boert/RFT-kicad-library/README.md

# RFT-kicad-library
KiCAD symbols for semiconductors from GDR

KiCAD-Symbole für in der DDR hergestellte Halbleiter

```
Achtung: Verwendung auf eigene Gefahr!

Die Bauteile wurden anhand der Datenblätter erstellt und 
nur zu einem sehr kleinen Teil in realen Schaltungen geprüft.

Hinweise zu Fehlern sowie Verbesserungen und Erweiterungen werden gern entgegengenommen.

```

folgende Bauteile sind momentan enthalten:

## Analogschaltkreise

Bezeichnung | Beschreibung
----------- | ------------
A109D       | Universeller OPV
A202D       | Aufnahme-, Mikrofon- und Wiedergabeverstärker
A211D       | 1W NF-Verstärker (optional mit Kühlfahne)
A220D       | FM-ZF-Verstärker und Demodulator
A225D       | FM-ZF-Verstärker
A244D       | Integrierter AM-Empfänger bis 30 MHz
A274D       | Höhen- und Tiefeneinstellung von Stereo-NF-Verstärkern
A277D       | Ansteuerschaltkreis für 12 LED, wahlweise im Punkt- oder Bandbetrieb
A290D       | Stereo-Dekoder
A301D       | Initiatorschaltung
A301V       | Initiatorschaltung
A302D       | Schwellspannungsschaltkreis
B060D       | Kleinleistungs-BIFET-OPV, externe Frequenzkompensation, Offsetabgleich
B061D       | Kleinleistungs-BIFET-OPV, interne Frequenzkompensation, Offsetabgleich
B062D       | zweifach Kleinleistungs-BIFET-OPV, interne Frequenzkompensation
B064D       | vierfach Kleinleistungs-BIFET-OPV, interne Frequenzkompensation
B066D       | Kleinleistungs-BIFET-OPV, interne Frequenzkompensation, Offsetabgleich, Leistungssteuerung
B080D       | BIFET-OPV, externe Frequenzkompensation, Offsetabgleich
B081D       | BIFET-OPV, interne Frequenzkompensation, Offsetabgleich
B082D       | zweifach BIFET-OPV, interne Frequenzkompensation
B083D       | zweifach BIFET-OPV, interne Frequenzkompensation, Offsetabgleich
B084D       | vierfach BIFET-OPV, interne Frequenzkompensation
B109D       | Universeller OPV
B165D       | Leistungs-OPV 20 W
B176D       | Programmierbarer OPV
B177D       | Programmierbarer OPV
B222D       | Doppelgegentaktmischer
B260D       | Ansteuerschaltkreis für Schaltnetzteile
B2761D      | 2-fach OPV mit offenem Kollektor
B2765D      | 2-fach OPV mit offenem Kollektor
B2765S      | 2-fach OPV mit Darlington-Ausgang
B2960VG     | Schaltregler-Schaltkreis
B303D       | Initiatorschaltkreis für induktive, kapazitive und optische Näherungsschalter
B3040DA     | Treiber-Sensor für Leiterplattentester
B304D       | Initiatorschaltkreis für induktive, kapazitive und optische Näherungsschalter
B305D       | Initiatorschaltkreis für induktive, kapazitive und optische Näherungsschalter, mit LED-Ausgang
B306D       | Initiatorschaltkreis für induktive, kapazitive und optische Näherungsschalter
B308D       | NF-Verstärker für Telefonhörer
B315D       | Transistor-Leistungs-Array
B3170V      | Positiv-Spannungsregler, einstellbar
B3171V      | Positiv-Spannungsregler, einstellbar
B318D       | NF-Verstärker für Telefonhörer
B325D       | Transistor-Leistungs-Array
B3370V      | Negativ-Spannungsregler, einstellbar
B3371V      | Negativ-Spannungsregler, einstellbar
B340D       | Transistor-Kleinleistungs-Array
B341D       | Transistor-Kleinleistungs-Array
B342D       | Transistor-Kleinleistungs-Array
B360D       | Transistor-Leistungs-Array
B3718VC     | Schrittmotor-Treiberschaltkreis
B380D       | Transistor-Leistungs-Array
B390D       | Regler für Gleichstromkleinstmotoren
B391D       | Motorprozessor für Kassettenlaufwerke
B3925DD     | Motorprozessor für Diskettenlaufwerke
B4002D      | Schnittstelle Logik zu Leistung
B411DD      | Präzisions-BIFET-OPV, interne Frequenzkompensation, Offsetabgleich
B451G       | Magnetisch betätigter (Hall-)Schalter
B452G       | Magnetisch betätigter (Hall-)Schalter
B453G       | Magnetisch betätigter (Hall-)Schalter
B460G       | Hall-Sensor mit analogem Ausgang
B461G       | Magnetisch betätigter (Hall-)Schalter, mit Freigabeeingang
B462G       | Magnetisch betätigter (Hall-)Schalter, mit Freigabeeingang
B4206D      | Drehzahlregelung, stromgeführt
B4207D      | Drehzahlregelung, tachogeführt
B4211D      | Drehzahlregelung, tachogeführt, Phasenanschnitt
B4761D      | 4-fach OPV mit offenem Kollektor
B4765D      | 4-fach OPV mit offenem Kollektor
B551N       | Temperatursensor 1 µA/K
B555D       | Zeitgeber mit 200-mA-Ausgang
B556D       | Zeitgeber mit 200-mA-Ausgang
B589N       | Referenzspannungsquelle 1,235 V
B611D       | OPV mit TTL-Ausgang
B615D       | OPV mit TTL-Ausgang
B621D       | OPV mit TTL-Ausgang
B625D       | OPV mit TTL-Ausgang
B631D       | OPV mit offenem Kollektor
B635D       | OPV mit offenem Kollektor
B654D       | Servomotor-Steuerschaltkreis mit Brückenschaltung
B761D       | OPV mit offenem Kollektor
B765D       | OPV mit offenem Kollektor
B861D       | OPV mit offenem Kollektor
B865D       | OPV mit offenem Kollektor
C500D       | Analog-Teil eines 2-Flanken-Umsetzers (14 Bit, 4 1/4 Digit)
C501D       | Analog-Teil eines 2-Flanken-Umsetzers (11 Bit, 3 1/2 Digit)
C502D       | Digital-Teil des 2-Flanken-Umsetzers mit Siebensegmentausgang
C504D       | Digital-Teil des 2-Flanken-Umsetzers mit BCD-Ausgang
C520D       | A/D-Umsetzer -2..+3 Stellen mit BCD-Ausgang
C560C       | 8-bit-D/A-Wandler mit Latch
C5650C      | 10-bit-D/A-Wandler ohne Latch
C5658C      | 8-bit-D/A-Wandler ohne Latch
C565C       | 12-bit-D/A-Wandler ohne Latch
C570C       | 8-bit-A/D-Wandler ohne Tristate
C571C       | 10-bit-A/D-Wandler ohne Tristate
C574C       | 12-bit-A/D-Wandler mit 8-bit-Businterface
C670C       | 8-bit-A/D-Wandler mit Tristate
C7136D      | 3 1/2-stelliger A/D-Umsetzer für LCD-Ansteuerung
E310        | Blinkgeberschaltung
U7650DD     | Chopperstabilisierter CMOS-OPV

## Optoelektronik

Bezeichnung | Beschreibung
----------- | ------------
L110C       | CCD-Zeile, 256 Pixel
L133C       | CCD-Zeile, 1024 Pixel
MB101       | GaAs-LED + Si-npn-Fototransistor
MB104       | Optoelektronischer Koppler aus IR-Diode und npn-Si-Fototransistor
MB105       | Optoelektronischer Koppler aus IR-Diode und npn-Si-Fototransistor
MB106       | GaAs-LED + Si-npn-Fototransistor
MB110       | Optoelektronischer Koppler aus GaAs-LED und Si-Fotodiode
MB111       | Optoelektronischer Koppler aus GaAs-LED und Si-Fotodiode, Ausgang open-collector, TTL-kompatibel
MB123       | Gabelkoppler: GaAs-LED + Si-Fototransistor
MB125       | Reflexkoppler: GaAs-LED + Si-Fototransistor
MB126       | Reflexkoppler: GaAs-LED + Si-Fototransistor
MB133       | IR-LED + Si-npn-Fototransistor
MB134       | IR-LED + Si-npn-Fototransistor
MB135       | IR-LED + Si-npn-Fototransistor
SP201       | Si-npn-Fototransistor in Plastverkappung
SP211       | Si-npn-Planar-Fototransistor im Metall-Keramik-Gehäuse
VQ110       | Infrarotemitterdiode 940nm, 4mm, rund
VQ120       | Infrarotemitterdiode 940nm, In-Loch-Montage
VQ121       | GaAs Infrarotemitterdiode 940nm, 2mm
VQ123       | Infrarotemitterdiode 940nm, 3mm, rund
VQ125       | Infrarotemitterdiode 900nm...980nm, 5mm, rund
VQA10       | Leuchtdiode rot, 635nm, 5mm, rund, rot diffus
VQA12       | Leuchtdiode rot, 630nm...690nm, 4mm, rund, rot diffus
VQA13       | Leuchtdiode rot, 660nm, 5mm, rund, diffus
VQA14       | Leuchtdiode rot, 635nm, 5mm, rechteckig anreihbar, teildiffus
VQA15       | Leuchtdiode rot, 660nm, 2mm, rund, farblos
VQA16       | Leuchtdiode rot, 635nm, 5mm, rund, Farbe klar
VQA17       | Leuchtdiode rot, 635nm, 3mm, rund, Farbe diffus
VQA18       | Leuchtdiode rot, 635nm, 5mm, rechteckig nicht anreihbar, teildiffus
VQA23       | Leuchtdiode grün, 560nm, 5mm, rund, diffus
VQA24       | Leuchtdiode grün, 560nm, 5mm, rechteckig anreihbar, teildiffus
VQA25       | Leuchtdiode grün, 560nm, 2mm, rund, Farbe klar
VQA26       | Leuchtdiode grün, 560nm, 5mm, rund, Farbe klar
VQA27       | Leuchtdiode grün, 560nm, 3mm, rund, Farbe diffus
VQA28       | Leuchtdiode grün, 560nm, 5mm, rechteckig nicht anreihbar, teildiffus
VQA33       | Leuchtdiode gelb, 590nm, 5mm, rund, diffus
VQA34       | Leuchtdiode gelb, 590nm, 5mm, rechteckig anreihbar, teildiffus
VQA35       | Leuchtdiode gelb, 590nm, 2mm, rund, Farbe klar
VQA36       | Leuchtdiode gelb, 590nm, 5mm, rund, Farbe klar
VQA37       | Leuchtdiode gelb, 590nm, 3mm, rund, Farbe diffus
VQA38       | Leuchtdiode gelb, 590nm, 5mm, rechteckig nicht anreihbar, teildiffus
VQA46       | Leuchtdiode orange, 610nm, 5mm, rund, Farbe klar
VQA47       | Leuchtdiode orange, 610nm, 3mm, rund, Farbe diffus
VQB16       | einstellige Lichtschachtanzeige, rot
VQB17       | einstellige Lichtschachtanzeige, rot, gemeinsame Kathode
VQB18       | einstellige Lichtschachtanzeige, rot, gemeinsame Anode
VQB26       | einstellige Lichtschachtanzeige, grün
VQB27       | einstellige Lichtschachtanzeige, grün, gemeinsame Kathode
VQB28       | einstellige Lichtschachtanzeige, grün, gemeinsame Anode
VQB37       | einstellige LED-Anzeige, rot, 3mm, gemeinsame Kathode
VQB71       | einstellige LED-Anzeige, rot, 7mm, gemeinsame Anode
VQB73       | plus/minus LED-Anzeige, rot, 7mm, gemeinsame Anode
VQB200      | 16-Segment-Lichtemitteranzeige, grün, gemeinsame Kathode
VQB201      | 16-Segment-Lichtemitteranzeige, grün, gemeinsame Anode
VQE11       | 1,5-stellige Lichtschachtanzeige, rot, gemeinsame Kathode
VQE12       | 1,5-stellige Lichtschachtanzeige, rot, gemeinsame Anode
VQE13       | zweistellige Lichtschachtanzeige, rot, gemeinsame Kathode
VQE14       | zweistellige Lichtschachtanzeige, rot, gemeinsame Anode
VQE21       | 1,5-stellige Lichtschachtanzeige, grün, gemeinsame Kathode
VQE22       | 1,5-stellige Lichtschachtanzeige, grün, gemeinsame Anode
VQE23       | zweistellige Lichtschachtanzeige, grün, gemeinsame Kathode
VQE24       | zweistellige Lichtschachtanzeige, grün, gemeinsame Anode

## Transistoren & Dioden

Bezeichnung | Beschreibung
----------- | ------------
GA100       | Germanium-Universaldiode, U<sub>R</sub>=20V, I<sub>F</sub>=20mA
GA101       | Germanium-Universaldiode, U<sub>R</sub>=40V, I<sub>F</sub>=15mA
GA102       | Germanium-Universaldiode, U<sub>R</sub>=60V, I<sub>F</sub>=12mA
GA103       | Germanium-Universaldiode, U<sub>R</sub>=80V, I<sub>F</sub>=10mA
GA104       | Germanium-Universaldiode, U<sub>R</sub>=110V, I<sub>F</sub>=10mA
GA105       | Germanium-Universaldiode, U<sub>R</sub>=20V, I<sub>F</sub>=20mA
GA108       | Germanium-Universaldiode, U<sub>R</sub>=80V, I<sub>F</sub>=20mA
GC100       | Ge-PNP-Transistor, U<sub>CE</sub>=-10V, I<sub>C</sub>=-15mA
GC101       | Ge-PNP-Transistor, rauscharm, U<sub>CE</sub>=-10V, I<sub>C</sub>=-15mA
GC115       | Ge-PNP-Transistor, U<sub>CE</sub>=-20V, I<sub>C</sub>=-50mA
GC116       | Ge-PNP-Transistor, U<sub>CE</sub>=-20V, I<sub>C</sub>=-50mA
GC117       | Ge-PNP-Transistor, rauscharm, U<sub>CE</sub>=-20V, I<sub>C</sub>=-50mA
GC120       | Ge-PNP-Transistor, U<sub>CE</sub>=-20V, I<sub>C</sub>=-150mA
GC121       | Ge-PNP-Transistor, U<sub>CE</sub>=-20V, I<sub>C</sub>=-150mA
GC122       | Ge-PNP-Transistor, U<sub>CE</sub>=-33V, I<sub>C</sub>=-150mA
GC123       | Ge-PNP-Transistor, U<sub>CE</sub>=-66V, I<sub>C</sub>=-150mA
GC301       | Ge-PNP-Transistor, U<sub>CE</sub>=-32V, I<sub>C</sub>=-500A
GD100       | Ge-PNP-Leistungstransistor, U<sub>CE</sub>=-18V, I<sub>C</sub>=-1,3A
GD110       | Ge-PNP-Leistungstransistor, U<sub>CE</sub>=-18V, I<sub>C</sub>=-1,3A
GD120       | Ge-PNP-Leistungstransistor, U<sub>CE</sub>=-30V, I<sub>C</sub>=-1,3A
GD130       | Ge-PNP-Leistungstransistor, U<sub>CE</sub>=-58V, I<sub>C</sub>=-1,3A
GD150       | Ge-PNP-Leistungstransistor, U<sub>CE</sub>=-18V, I<sub>C</sub>=-3,0A
GD160       | Ge-PNP-Leistungstransistor, U<sub>CE</sub>=-18V, I<sub>C</sub>=-3,0A
GD170       | Ge-PNP-Leistungstransistor, U<sub>CE</sub>=-30V, I<sub>C</sub>=-3,0A
GD175       | Ge-PNP-Leistungstransistor, U<sub>CE</sub>=-48V, I<sub>C</sub>=-3,0A
GD180       | Ge-PNP-Leistungstransistor, U<sub>CE</sub>=-60V, I<sub>C</sub>=-3,0A
GD240       | Ge-PNP-Leistungstransistor, U<sub>CE</sub>=-25V, I<sub>C</sub>=-3,0A, P<sub>tot</sub>=10W
GD241       | Ge-PNP-Leistungstransistor, U<sub>CE</sub>=-35V, I<sub>C</sub>=-3,0A, P<sub>tot</sub>=10W
GD242       | Ge-PNP-Leistungstransistor, U<sub>CE</sub>=-48V, I<sub>C</sub>=-3,0A, P<sub>tot</sub>=10W
GD243       | Ge-PNP-Leistungstransistor, U<sub>CE</sub>=-60V, I<sub>C</sub>=-3,0A, P<sub>tot</sub>=10W
GD244       | Ge-PNP-Leistungstransistor, U<sub>CE</sub>=-70V, I<sub>C</sub>=-3,0A, P<sub>tot</sub>=10W
GF100       | Ge-PNP-HF-Transistor, I<sub>C</sub>=-15mA
GF105       | Ge-PNP-HF-Transistor, I<sub>C</sub>=-15mA
GF120       | Ge-PNP-HF-Transistor, U<sub>CE</sub>=-15V, I<sub>C</sub>=-10mA
GF121       | Ge-PNP-HF-Transistor, U<sub>CE</sub>=-15V, I<sub>C</sub>=-10mA
GF122       | Ge-PNP-HF-Transistor, U<sub>CE</sub>=-15V, I<sub>C</sub>=-10mA
GF145       | Ge-PNP-HF-Transistor, U<sub>CE</sub>=-15V, I<sub>C</sub>=-10mA
GF147       | Ge-PNP-HF-Transistor, U<sub>CE</sub>=-15V, I<sub>C</sub>=-10mA
GS109       | Ge-PNP-Schalttransistor, U<sub>CE</sub>=-15V, I<sub>C</sub>=-50mA
GS111       | Ge-PNP-Schalttransistor, U<sub>CE</sub>=-15V, I<sub>C</sub>=-200mA
GS112       | Ge-PNP-Schalttransistor, U<sub>CE</sub>=-15V, I<sub>C</sub>=-200mA
GS121       | Ge-PNP-Schalttransistor, U<sub>CE</sub>=-20V, I<sub>C</sub>=-100mA
GS122       | Ge-PNP-Schalttransistor, U<sub>CE</sub>=-20V, I<sub>C</sub>=-100mA
OC815       | Ge-PNP-Transistor, U<sub>CE</sub>=-20V, I<sub>C</sub>=-50mA
OC816       | Ge-PNP-Transistor, U<sub>CE</sub>=-20V, I<sub>C</sub>=-50mA
OC817       | Ge-PNP-Transistor, rauscharm, U<sub>CE</sub>=-20V, I<sub>C</sub>=-50mA
OC820       | Ge-PNP-Transistor, U<sub>CE</sub>=-20V, I<sub>C</sub>=-150mA
OC821       | Ge-PNP-Transistor, U<sub>CE</sub>=-20V, I<sub>C</sub>=-150mA
OC822       | Ge-PNP-Transistor, U<sub>CE</sub>=-33V, I<sub>C</sub>=-150mA
OC823       | Ge-PNP-Transistor, U<sub>CE</sub>=-66V, I<sub>C</sub>=-150mA
OC830       | Ge-PNP-Leistungstransistor, U<sub>CE</sub>=-18V, I<sub>C</sub>=-1,3A
OC831       | Ge-PNP-Leistungstransistor, U<sub>CE</sub>=-18V, I<sub>C</sub>=-1,3A
OC832       | Ge-PNP-Leistungstransistor, U<sub>CE</sub>=-30V, I<sub>C</sub>=-1,3A
OC833       | Ge-PNP-Leistungstransistor, U<sub>CE</sub>=-58V, I<sub>C</sub>=-1,3A
OC835       | Ge-PNP-Leistungstransistor, U<sub>CE</sub>=-18V, I<sub>C</sub>=-3,0A
OC836       | Ge-PNP-Leistungstransistor, U<sub>CE</sub>=-18V, I<sub>C</sub>=-3,0A
OC837       | Ge-PNP-Leistungstransistor, U<sub>CE</sub>=-30V, I<sub>C</sub>=-3,0A
OC838       | Ge-PNP-Leistungstransistor, U<sub>CE</sub>=-60V, I<sub>C</sub>=-3,0A
OC870       | Ge-PNP-Transistor, U<sub>CE</sub>=-10V, I<sub>C</sub>=-15mA
OC871       | Ge-PNP-HF-Transistor, I<sub>C</sub>=-15mA
OC872       | Ge-PNP-HF-Transistor, I<sub>C</sub>=-15mA
OC880       | Ge-PNP-HF-Transistor, U<sub>CE</sub>=-15V, I<sub>C</sub>=-10mA
OC881       | Ge-PNP-HF-Transistor, U<sub>CE</sub>=-15V, I<sub>C</sub>=-10mA
OC882       | Ge-PNP-HF-Transistor, U<sub>CE</sub>=-25V, I<sub>C</sub>=-10mA
GY099       | Ge-Diode, U<sub>R</sub>=12V, I<sub>F</sub>=100mA
GY100       | Ge-Diode, U<sub>R</sub>=24V, I<sub>F</sub>=100mA
GY101       | Ge-Diode, U<sub>R</sub>=40V, I<sub>F</sub>=100mA
GY102       | Ge-Diode, U<sub>R</sub>=75V, I<sub>F</sub>=100mA
GY103       | Ge-Diode, U<sub>R</sub>=100V, I<sub>F</sub>=100mA
GY104       | Ge-Diode, U<sub>R</sub>=150V, I<sub>F</sub>=100mA
GY105       | Ge-Diode, U<sub>R</sub>=200V, I<sub>F</sub>=100mA
SA403       | Si-Planar-Diode, U<sub>R</sub>=25V, I<sub>F</sub>=30mA, Farbpunkt rot
SA412       | Si-Epitaxie-Diode, U<sub>R</sub>=20V, I<sub>F</sub>=80mA, Farbpunkt gelb
SA418       | Si-Epitaxie-Diode, U<sub>R</sub>=80V, I<sub>F</sub>=100mA, Farbpunkt grün
SAL41       | Silizium-Doppeldiode, schneller Schalter
SAL41B      | Silizium-Doppeldiode, schneller Schalter
SAL41K      | Silizium-Doppeldiode, schneller Schalter, ohne Mittelabgriff
SAL43       | Silizium-Mehrfachdiode, schneller Schalter
SAL45       | Silizium-Mehrfachdiode, schneller Schalter
SAM42       | Si-Doppeldiode, gemeinsame Kathode, schneller Schalter
SAM43       | Si-Dreifachdiode, gemeinsame Kathode, schneller Schalter
SAM44       | Si-Vierfachdiode, gemeinsame Kathode, schneller Schalter
SAM45       | Si-Fünffachdiode, gemeinsame Kathode, schneller Schalter
SAM62       | Si-Doppeldiode, gemeinsame Anode, schneller Schalter
SAM63       | Si-Dreifachdiode, gemeinsame Anode, schneller Schalter
SAM64       | Si-Vierfachdiode, gemeinsame Anode, schneller Schalter
SAM65       | Si-Fünffachdiode, gemeinsame Anode, schneller Schalter
SAY10       | Si-Schaltdiode, U<sub>R</sub>=50V, I<sub>F</sub>=175mA, 3. rot, 4. rot
SAY11       | Si-Schaltdiode, U<sub>R</sub>=25V, I<sub>F</sub>=115mA, 3. rot, 4. gelb
SAY12       | Si-Schaltdiode, U<sub>R</sub>=50V, I<sub>F</sub>=300mA, orange (alt: 3. rot, 4. orange)
SAY13       | Si-Schaltdiode, Markierung 3. rot, 4. grün
SAY14       | Si-Schaltdiode, U<sub>R</sub>=25V, I<sub>F</sub>=115mA, 3. rot, 4. blau
SAY15       | Si-Schaltdiode, U<sub>R</sub>=15V, I<sub>F</sub>=75mA, 3. rot, 4. weiß
SAY16       | Si-Schaltdiode, U<sub>R</sub>=30V, I<sub>F</sub>=300mA, grün (alt: 3. gelb, 4. rot)
SAY17       | Si-Schaltdiode, U<sub>R</sub>=50V, I<sub>F</sub>=175mA, rot
SAY18       | Si-Schaltdiode, U<sub>R</sub>=25V, I<sub>F</sub>=115mA, gelb
SAY20       | Si-Schaltdiode, U<sub>R</sub>=15V, I<sub>F</sub>=75mA, blau
SAY30       | Si-Planar-Diode, U<sub>R</sub>=25V, I<sub>F</sub>=30mA
SAY32       | Si-Planar-Diode, U<sub>R</sub>=25V, I<sub>F</sub>=50mA
SAY40       | Si-Planar-Diode, U<sub>R</sub>=15V, I<sub>F</sub>=30mA
SAY42       | Si-Planar-Diode, U<sub>R</sub>=15V, I<sub>F</sub>=50mA
SAY50       | Si-Doppeldiode, gemeinsame Kathode
SAY52       | Si-Doppeldiode, gemeinsame Kathode
SAY60       | Si-Doppeldiode, gemeinsame Kathode
SAY62       | Si-Doppeldiode, gemeinsame Kathode
SAY73       | Si-Schaltdiode, U<sub>R</sub>=50V, I<sub>F</sub>=300mA, weiß
SAZ12       | Si-Kapazitätsdiode, U<sub>R</sub>=18V, f<sub>Q</sub>>10GHz
SAZ13       | Si-Kapazitätsdiode, U<sub>R</sub>=18V, f<sub>Q</sub>>20GHz
SC206       | Si-NPN-Transistor, U<sub>ce</sub>=20V, I<sub>c</sub>=100mA, E-Line
SC207       | Si-NPN-Transistor, U<sub>ce</sub>=20V, I<sub>c</sub>=100mA, E-Line
SC236       | Si-NPN-Transistor für NF-Vor- und Treiberstufen, U<sub>ce</sub>=20V, I<sub>c</sub>=100mA, E-Line
SC237       | Si-NPN-Transistor für NF-Vor- und Treiberstufen, U<sub>ce</sub>=45V, I<sub>c</sub>=100mA, E-Line
SC238       | Si-NPN-Transistor für NF-Vor- und Treiberstufen, U<sub>ce</sub>=20V, I<sub>c</sub>=100mA, E-Line
SC239       | Si-NPN-Transistor für NF-Vor- und Treiberstufen, rauscharm, U<sub>ce</sub>=20V, I<sub>c</sub>=100mA, E-Line
SC307       | Si-PNP-Transistor, NF, allgemein
SC308       | Si-PNP-Transistor, NF, allgemein
SC309       | Si-PNP-Transistor, NF, allgemein, rauscharm
SD168       | Si-NPN-Leistungstransistor, U<sub>ce</sub>=300V, I<sub>c</sub>=3A, TO-3
SF121       | Si-NPN-HF-Transistor, U<sub>ce</sub>=20V, I<sub>c</sub>=100mA, TO-39
SF122       | Si-NPN-HF-Transistor, U<sub>ce</sub>=33V, I<sub>c</sub>=100mA, TO-39
SF123       | Si-NPN-HF-Transistor, U<sub>ce</sub>=66V, I<sub>c</sub>=100mA, TO-39
SF126       | Si-NPN-HF-Transistor, U<sub>ce</sub>=20V, I<sub>c</sub>=500mA, TO-39
SF127       | Si-NPN-HF-Transistor, U<sub>ce</sub>=30V, I<sub>c</sub>=500mA, TO-39
SF128       | Si-NPN-HF-Transistor, U<sub>ce</sub>=60V, I<sub>c</sub>=500mA, TO-39
SF129       | Si-NPN-HF-Transistor, U<sub>ce</sub>=80V, I<sub>c</sub>=500mA, TO-39
SF131       | Si-NPN-HF-Transistor, U<sub>ce</sub>=12V, I<sub>c</sub>=50mA, TO-18
SF132       | Si-NPN-HF-Transistor, U<sub>ce</sub>=15V, I<sub>c</sub>=50mA, TO-18
SF136       | Si-NPN-HF-Transistor, U<sub>ce</sub>=12V, I<sub>c</sub>=200mA, TO-18
SF137       | Si-NPN-HF-Transistor, U<sub>ce</sub>=20V, I<sub>c</sub>=200mA, TO-18
SF150       | Si-NPN-HF-Transistor, U<sub>ce</sub>=160V, I<sub>c</sub>=50mA, TO-39
SF215       | Si-NPN-HF-Transistor, U<sub>ce</sub>=15V, I<sub>c</sub>=100mA, E-Line
SF216       | Si-NPN-HF-Transistor, U<sub>ce</sub>=20V, I<sub>c</sub>=100mA, E-Line
SF225       | Si-NPN-HF-Transistor, U<sub>ce</sub>=25V, I<sub>c</sub>=25mA, E-Line CEB!
SF235       | Si-NPN-HF-Transistor, U<sub>ce</sub>=25V, I<sub>c</sub>=25mA, E-Line
SF240       | Si-NPN-HF-Transistor, U<sub>ce</sub>=30V, I<sub>c</sub>=25mA, E-Line CEB!
SF245       | Si-NPN-HF-Transistor, U<sub>ce</sub>=25V, I<sub>c</sub>=25mA, E-Line CEB!
SF357       | Si-NPN-HF-Transistor, U<sub>ce</sub>=160V, I<sub>c</sub>=100mA, TO-126
SF358       | Si-NPN-HF-Transistor, U<sub>ce</sub>=250V, I<sub>c</sub>=100mA, TO-126
SF359       | Si-NPN-HF-Transistor, U<sub>ce</sub>=300V, I<sub>c</sub>=100mA, TO-126
SM103       | Si-N-Kanal MOSFET, I<sub>d</sub>=15mA, V<sub>ds</sub>=20V
SM104       | Si-N-Kanal MOSFET, I<sub>d</sub>=15mA, V<sub>ds</sub>=20V
SMY50       | P-Kanal MOSFET, I<sub>d</sub>=-25mA, V<sub>ds</sub>=-31V
SMY51       | Doppel-P-Kanal MOSFET, I<sub>d</sub>=-20mA, V<sub>ds</sub>=-31V
SMY52       | P-Kanal MOSFET, I<sub>d</sub>=-60mA, V<sub>ds</sub>=-31V
SMY60       | Doppel-P-Kanal MOSFET, I<sub>d</sub>=-20mA, V<sub>ds</sub>=-25V
SS106       | Si-NPN-Schalttransistor, U<sub>ce</sub>=15V, I<sub>c</sub>=200mA, TO-18
SS108       | Si-NPN-Schalttransistor, U<sub>ce</sub>=15V, I<sub>c</sub>=200mA, TO-18
SS109       | Si-NPN-Schalttransistor, U<sub>ce</sub>=15V, I<sub>c</sub>=200mA, TO-18
SS200       | Si-NPN mit höherer Sperrspannung, U<sub>ce</sub>=70V, I<sub>c</sub>=30mA, E-Line
SS201       | Si-NPN mit höherer Sperrspannung, U<sub>ce</sub>=100V, I<sub>c</sub>=30mA, E-Line
SS202       | Si-NPN mit höherer Sperrspannung, U<sub>ce</sub>=120V, I<sub>c</sub>=30mA, E-Line
SS216       | Si-NPN-Schalttransistor, U<sub>ce</sub>=15V, I<sub>c</sub>=100mA, E-Line
SS218       | Si-NPN-Schalttransistor, U<sub>ce</sub>=15V, I<sub>c</sub>=100mA, E-Line
SS219       | Si-NPN-Schalttransistor, U<sub>ce</sub>=15V, I<sub>c</sub>=100mA, E-Line
SSY20       | Si-NPN-Schalttransistor für EDV, U<sub>ce</sub>=40V, I<sub>c</sub>=600mA, TO-39
ST103       | Si-Kleinleistungsthyristor, 3A, 100V...600V
SU161       | Si-NPN-Leistungstransistor, U<sub>ce</sub>=700V, I<sub>c</sub>=2,5A, TO-3
SU165       | Si-NPN-Leistungstransistor, U<sub>ce</sub>=350V, I<sub>c</sub>=2,5A, TO-3
SY200       | Si-Gleichrichterdiode, U<sub>R</sub>=75V, I<sub>F</sub>=1A
SY201       | Si-Gleichrichterdiode, U<sub>R</sub>=100V, I<sub>F</sub>=1A
SY202       | Si-Gleichrichterdiode, U<sub>R</sub>=200V, I<sub>F</sub>=1A
SY203       | Si-Gleichrichterdiode, U<sub>R</sub>=300V, I<sub>F</sub>=1A
SY204       | Si-Gleichrichterdiode, U<sub>R</sub>=400V, I<sub>F</sub>=1A
SY205       | Si-Gleichrichterdiode, U<sub>R</sub>=500V, I<sub>F</sub>=1A
SY206       | Si-Gleichrichterdiode, U<sub>R</sub>=600V, I<sub>F</sub>=1A
SY207       | Si-Gleichrichterdiode, U<sub>R</sub>=700V, I<sub>F</sub>=1A
SY208       | Si-Gleichrichterdiode, U<sub>R</sub>=800V, I<sub>F</sub>=1A
SY210       | Si-Gleichrichterdiode, U<sub>R</sub>=1000V, I<sub>F</sub>=1A
SY320/xx    | Si-Diode, U<sub>R</sub>=75V...1000V, I<sub>F</sub>=0,95A
SY330/xx    | Schnelle-Si-Diode, U<sub>R=100V...2000V, I<sub>F</sub>=0,48A...0,29A
SY335/xx    | Schnelle-Si-Diode, U<sub>R</sub>=50V...800V, I<sub>F</sub>=1,4A...1,0A
SY345/xx    | Schnelle Si-Gleichrichteriode, U_<sub>R</sub>=35V...700V, I_<sub>F</sub>=1A
SY351/xx    | Gleichrichteriode, U_<sub>R</sub>=50V...1600V, I_<sub>F</sub>=3A
SZX18/xx    | Z-Diode in Allglasausführung, Farbring schwarz
SZX19/xx    | Z-Diode in Allglasausführung, Farbring rot
SZX21/xx    | Si-Epitaxie-Planardioden, Zenerspannung 1;5,1..24
SZY20       | Spannungsreferenz 8,4 ± 0,4V, ΔU ≤ 66mV, Farbpunkt schwarz
SZY21       | Spannungsreferenz 8,4 ± 0,4V, ΔU ≤ 33mV, Farbpunkt gelb
SZY22       | Spannungsreferenz 8,4 ± 0,4V, ΔU ≤ 13,2mV, Farbpunkt mittelblau
SZY23       | Spannungsreferenz 8,4 ± 0,4V, ΔU ≤ 6,6mV, Farbpunkt rot
U105D       | 6fach-P-Kanal MOSFET, gemeinsamer Source-Pin, I<sub>d</sub>=-3mA, V<sub>ds</sub>=-31V, DIP14

## Digitalschaltkreise

Bezeichnung | Beschreibung
----------- | ------------
75450       | Doppelperipherietreiber, Doppelleistungstreiber
D100D       | NAND-Gatter mit 2 Eingängen
D103D       | 4 NAND-Gatter mit je 2 Eingängen und offenem Kollektor
D104D       | 6 Inverter
D108D       | 4 AND-Gatter mit je 2 Eingängen
D110D       | 3 NAND-Gatter mit je 3 Eingängen
D120D       | 2 NAND-Gatter mit je 4 Eingängen
D121D       | Monostabiler Multivibrator mit Schmitt-Trigger-Eingängen
D122D       | 2-Kanal-Leseverstärker
D123D       | 2-Kanal-Leseverstärker
D126D       | 4 NAND-Gatter mit je 2 Eingängen und offenem Kollektor, 12V
D130D       | 1 NAND-Gatter mit 8 Eingängen
D140D       | 2 NAND-Treiber mit je 4 Eingängen
D174D       | 2 positiv flanken-getrigge D-Flip-Flop
D192D       | synchroner Vor-Rückwärts-Dezimalzähler
D193D       | synchroner Vor-Rückwärts-Binärzähler
D195D       | 4 Bit Links-Rechts-Schieberegister
D200D       | 4 NAND-Gatter mit je 2 Eingängen
D201D       | 4 NAND-Gatter mit je 2 Eingängen und offenem Kollektor
D204D       | 6 Inverter
D210D       | 3 NAND-Gatter mit je 3 Eingängen
D220D       | 2 NAND-Gatter mit je 4 Eingängen
D230D       | 1 NAND-Gatter mit 8 Eingängen
D240D       | 2 NAND-Treiber mit je 4 Eingängen
D274D       | 2 positiv flanken-getrigge D-Flip-Flop
D345D       | BCD-zu-7-Segment-Dekoder, hexadezimal
D346D       | BCD-zu-7-Segment-Dekoder, hexadezimal, einstellbar
D347D       | BCD-zu-7-Segment-Dekoder, Anzeige für C520
D348D       | BCD-zu-7-Segment-Dekoder, Anzeige für C520, einstellbar
D492D       | 6 Digitaltreiber, invertierend
DL000D      | 4 NAND-Gatter mit je 2 Eingängen
DL002D      | 4 NOR-Gatter mit je 2 Eingängen
DL003D      | 4 NAND-Gatter mit je 2 Eingängen und offenem Kollektor
DL004D      | 6 Inverter
DL005DC     | 6 Inverter mit offenem Kollektor
DL008D      | 4 AND-Gatter mit je 2 Eingängen
DL010D      | 3 NAND-Gatter mit je 3 Eingängen
DL011D      | 3 AND-Gatter mit je 3 Eingängen
DL014D      | 6 Schmitt-Trigger-Inverter
DL016D      | 6 Inverter mit offenem Kollektor
DL020D      | 2 NAND-Gatter mit je 4 Eingängen
DL021D      | 2 AND-Gatter mit je 4 Eingängen
DL026D      | 4 NAND-Gatter mit je 2 Eingängen und offenem Kollektor, 15V
DL030D      | 1 NAND-Gatter mit 8 Eingängen
DL032D      | 4 OR-Gatter mit je 2 Eingängen
DL037D      | 4 NAND-Treiber mit je 2 Eingängen
DL038D      | 4 NAND-Treiber mit je 2 Eingängen, offener Kollektor
DL040D      | 2 NAND-Treiber mit je 4 Eingängen
DL051D      | 2 AND-NOR-Getter mit 2×3 Eingängen bzw. 2×2 Eingängen
DL074D      | 2 positiv flanken-getriggerte D-Flip-Flop
DL083D      | 4 Bit Volladdierer
DL086D      | 4 Exklusiv-OR-Gatter mit je 2 Eingängen
DL090D      | Dezimalzähler 4 Bit
DL093D      | 4 Bit Binärzähler
DL112D      | 2 negativ flanken-getriggerte JK-Flip-Flop
DL123D      | 2 rücksetzbare monostabile Multivibratoren
DL132D      | 4 Schmitt-Trigger-NAND-Gatter mit je 2 Eingängen
DL155D      | Dekoder/Demultiplexer
DL164D      | 8 Bit Schieberegister
DL175D      | 4 D-Flip-Flop, gemeinsamer Clear- und Takteingang
DL192D      | synchroner Vor-Rückwärts-Dezimalzähler
DL193D      | synchroner Vor-Rückwärts-Binärzähler
DL194D      | Bidirektionales 4-bit-Schieberegister
DL251D      | 8- auf 1-Multiplexer mit Tristate-Ausgängen
DL253D      | Zweifach 4- auf 1-Multiplexer mit Tristate-Ausgängen
DL257D      | Vierfach 2- auf 1-Multiplexer mit Tristate-Ausgängen
DL259D      | 8-Bit-Latch, adressierbar, mit Enable und Clear
DL295D      | 4 Bit Rechts-/Links-Schieberegister
DL299D      | 8 Bit Universalschieberegister
DL374D      | 8 D-Flip-Flop mit Freigabeeingang
DL540D      | Bit Leitungstreiber, invertierend, Tristate-Ausgänge
DL541D      | Bit Leitungstreiber, nichtinvertierend, Tristate-Ausgänge
DS8205D     | 1-aus-8 Binärdekoder
DS8212D     | 8 Bit Bustreiber mit Speicher, Tristate-Ausgänge
DS8216D     | Paraleller bidirektionaler 4 Bit Bustreiber, Tristate-Ausgänge
DS8282D     | 8 Bit Bustreiber mit Speicher, Tristate-Ausgänge
DS8283D     | 8 Bit Bustreiber mit Speicher, Tristate-Ausgänge, invertierend
DS8286D     | 8 Bit bidirektionaler Bustreiber, Tristate-Ausgänge
DS8287D     | 8 Bit bidirektionaler Bustreiber, Tristate-Ausgänge, invertierend
U125D       | 4-Dekaden-Zähler mit 7-Segment-Multiplexausgang
U192D       | 1½-stelliger Siebensegment-Dekoder
U202D       | 1K × 1 Bit statischer RAM
U214D       | 1K × 4 Bit statischer RAM
U224D       | 1K × 4 Bit statischer RAM
U2164C      | 64K × 1 Bit dynamischer RAM
U2716       | 2k × 8 bit UV-löschbarer Festwertspeicher (EPROM)
U2732       | 4k × 8 bit UV-löschbarer Festwertspeicher (EPROM)
U2764       | 8k × 8 bit UV-löschbarer Festwertspeicher (EPROM)
U27128      | 16k × 8 bit UV-löschbarer Festwertspeicher (EPROM)
U27256      | 32k × 8 bit UV-löschbarer Festwertspeicher (EPROM)
U27512      | 64k × 8 bit UV-löschbarer Festwertspeicher (EPROM)
U6264D      | 8K × 8 Bit statischer RAM
U6516D      | 2K × 8 Bit statischer CMOS RAM
U555C       | 1K × 8 bit UV-löschbarer Festwertspeicher (EPROM)
U855D       | PIO, Schaltkreis für parallele Ein-/Ausgabe
U856D       | SIO, Schaltkreis für serielle Ein-/Ausgabe
U857D       | CTC, Zähler-Zeitgeber-Schaltkreis
U880D       | CPU, Zentrale Verarbeitungseinheit
UB8001C     | 16-bit-Mikroprozessor
UB8810D     | 8-bit-Controller mit 2 kByte maskenprogrammierten ROM, 128 Byte RAM
UB8811D     | 8-bit-Controller mit 2 kByte maskenprogrammierten ROM, 128 Byte RAM, power down Option
UB8820M     | 8-bit-Controller mit 2 kByte externem ROM, 128 Byte RAM
UB8821M     | 8-bit-Controller mit 2 kByte externem ROM, 128 Byte RAM, power down Option
UB8830D     | 8-bit-Controller mit BASIC-Interpreter und Bootloader, 128 Byte RAM
UB8831D     | 8-bit-Controller mit BASIC-Interpreter und Bootloader, 128 Byte RAM, power down Option
UB8840M     | 8-bit-Controller mit 4 kByte externem ROM, 128 Byte RAM
UB8841M     | 8-bit-Controller mit 4 kByte externem ROM, 128 Byte RAM, power down Option
UB8860D     | 8-bit-Controller ROM-los, 128 Byte RAM
UB8861D     | 8-bit-Controller ROM-los, 128 Byte RAM, power down Option
U8611DC     | 8-bit-Controller mit 4 kByte maskenprogrammierten ROM, 128 Byte RAM
U8611DC/1   | 8-bit-Controller interner ROM nicht nutzbar, 128 Byte RAM
V4001D      | 4 NOR-Gatter mit je 2 Eingängen
V4007D      | 2 Transistorpaare und 1 Inverter
V4011D      | 4 NAND-Gatter mit je 2 Eingängen
V4012D      | 2 NAND-Gatter mit je 4 Eingängen
V4013D      | 2 D-Flip-Flop
V4015D      | 2 4-Bit Schieberegister
V4017D      | Dekadischer Zähler mit 10 dekodierten Ausgängen
V4019D      | AND/OR-Auswahlgatter mit 2 Eingängen und gemeinsamer Auswahl
V4023D      | 3 NAND-Gatter mit je 3 Eingängen
V4027D      | 2 Master-Slave-JK-Flip-Flop
V4028D      | BCD-zu-Dezimal-Dekoder
V4029D      | Synchroner 4-stufiger binärer BCD-Vor-Rückwärtszähler mit Voreinstellung
V4030D      | 4 Exklusiv-OR-Gatter mit je 2 Eingängen
V4034D      | 8-stufiges bidirektionales paralleles/serielles Busregister
V4035D      | 4-stufiges getaktetes serielles Schieberegister
V4042D      | 4-bit Auffangregister
V4044D      | 4 RS-Flip-Flop
V4046D      | PLL-Schaltung
V4048D      | Multifunktionsgatter
V4050D      | 6 nichtinvertierende Treiberstufen
V4051D      | 8-Kanal Anlaog-Multiplexer/Demultiplexer
V4066D      | 4 bilaterale Schalter
V4093D      | 4 Schmitt-Trigger-NAND-Gatter mit je 2 Eingängen
V40098D     | 6 invertierende Treiber mit Tristate-Ausgängen
V40511D     | BCD-zu-7-Segment-Dekoder
V4520D      | 2 binäre 4-Bit-Vorwärtszähler
V4531D      | 13-Bit-Paritätsprüfer
V4538D      | 2 Monoflop
V4585D      | 4 Bit Größenkomparator

## Relais

Bezeichnung | Beschreibung
----------- | ------------
GBR7        | Relais, 2 Umschalter
GBR10       | Neutrales elektromagnetisches Relais
GBR11       | Neutrales elektromagnetisches Relais
GBR12       | Neutrales elektromagnetisches Relais
GBR13       | Neutrales elektromagnetisches Relais
GBR15       | Relais, 2 Umschalter
GBR20       | Neutrales elektromagnetisches Relais
GBR101      | Relais, 2 Umschalter
GBR111      | Relais, 2 Umschalter
NSF30       | Relais
RGK13       | DIL-Relais in Flachbauform
RGS13       | SIL-Relais in Flachbauform
RGT13       | DIL-Trennrelais in Flachbauform
RGK20/1     | Relais, 1 Schließer
RGK20/2     | Relais, 2 Schließer
RGK30/1     | Relais, 1 Schließer
RGK30/2     | Relais, 2 Schließer

## Steckverbinder

### direkte Steckverbinder
Bezeichnung                | Beschreibung
-----------                | ------------
EFS26-Direktverbinder      | Direktverbinder 202 - 26 TGL 29331/01, Leiterplattenanschluß, gewinkelt, 2,5mm, 2x13
EFS58-Direktverbinder      | Direktverbinder 202 - 58 TGL 29331/01, Leiterplattenanschluß, gewinkelt, 2,5mm, 2x29
EFS90-Direktverbinder      | Direktverbinder 202 - 90 TGL 29331/01, Leiterplattenanschluß, gewinkelt, 2,5mm, 2x45
EFS14-Direktverbinder      | Direktverbinder 205 - 14 TGL 29331/01, Leiterplattenanschluß, gewinkelt, 5mm, 2x7
EFS30-Direktverbinder      | Direktverbinder 205 - 30 TGL 29331/01, Leiterplattenanschluß, gewinkelt, 5mm, 2x15
EFS46-Direktverbinder      | Direktverbinder 205 - 46 TGL 29331/01, Leiterplattenanschluß, gewinkelt, 5mm, 2x23
EFS26-Direktverbinder      | Direktverbinder 212 - 26 TGL 29331/01, Leiterplattenanschluß, gerade, 2,5mm, 2x13
EFS58-Direktverbinder      | Direktverbinder 212 - 58 TGL 29331/01, Leiterplattenanschluß, gerade, 2,5mm, 2x29
EFS90-Direktverbinder      | Direktverbinder 212 - 90 TGL 29331/01, Leiterplattenanschluß, gerade, 2,5mm, 2x45
EFS14-Direktverbinder      | Direktverbinder 215 - 14 TGL 29331/01, Leiterplattenanschluß, gerade, 5mm, 2x7
EFS30-Direktverbinder      | Direktverbinder 215 - 30 TGL 29331/01, Leiterplattenanschluß, gerade, 5mm, 2x15
EFS46-Direktverbinder      | Direktverbinder 215 - 46 TGL 29331/01, Leiterplattenanschluß, gerade, 5mm, 2x23
EFS26-Direktverbinder      | Direktverbinder 222 - 26 TGL 29331/01, Lötanschluß, gerade, 2,5mm, 2x13
EFS58-Direktverbinder      | Direktverbinder 222 - 58 TGL 29331/01, Lötanschluß, gerade, 2,5mm, 2x29
EFS90-Direktverbinder      | Direktverbinder 222 - 90 TGL 29331/01, Lötanschluß, gerade, 2,5mm, 2x45
EFS14-Direktverbinder      | Direktverbinder 225 - 14 TGL 29331/01, Lötanschluß, gerade, 5mm, 2x7
EFS30-Direktverbinder      | Direktverbinder 225 - 30 TGL 29331/01, Lötanschluß, gerade, 5mm, 2x15
EFS46-Direktverbinder      | Direktverbinder 225 - 46 TGL 29331/01, Lötanschluß, gerade, 5mm, 2x23

### indirekte Steckverbinder

Bezeichnung                | Beschreibung
-----------                | ------------
EFS10-Steckerleiste        | Steckerleiste 102 - 10 TGL 29331/04, Leiterplattenanschluß, gewinkelt, h=8,7mm, 2x5, a-b
EFS26-Steckerleiste        | Steckerleiste 102 - 26 TGL 29331/04, Leiterplattenanschluß, gewinkelt, h=8,7mm, 2x13, a-b
EFS58-Steckerleiste        | Steckerleiste 102 - 58 TGL 29331/03, Leiterplattenanschluß, gewinkelt, h=8,7mm, 2x29, a-b
EFS90-Steckerleiste        | Steckerleiste 102 - 90 TGL 29331/03, Leiterplattenanschluß, gewinkelt, h=8,7mm, 2x45, a-b
EFS05-Steckerleiste        | Steckerleiste 103 - 05 TGL 29331/04, Leiterplattenanschluß, gewinkelt, h=8,7mm, 1x5, versetzt
EFS13-Steckerleiste        | Steckerleiste 103 - 13 TGL 29331/04, Leiterplattenanschluß, gewinkelt, h=8,7mm, 1x13, versetzt
EFS29-Steckerleiste        | Steckerleiste 103 - 29 TGL 29331/03, Leiterplattenanschluß, gewinkelt, h=8,7mm, Raster 2,5mm versetzt
EFS45-Steckerleiste        | Steckerleiste 103 - 45 TGL 29331/03, Leiterplattenanschluß, gewinkelt, h=8,7mm, Raster 2,5mm versetzt
EFS30-Steckerleiste        | Steckerleiste 107 - 30 TGL 29331/03, Leiterplattenanschluß, gewinkelt, h=8,7mm, 2x15, a-b
EFS46-Steckerleiste        | Steckerleiste 107 - 46 TGL 29331/03, Leiterplattenanschluß, gewinkelt, h=8,7mm, 2x23, a-b
EFS10-Steckerleiste        | Steckerleiste 112 - 10 TGL 29331/04, Leiterplattenanschluß, gerade, h=8,5mm, 2x5, a-b
EFS26-Steckerleiste        | Steckerleiste 112 - 26 TGL 29331/04, Leiterplattenanschluß, gerade, h=8,5mm, 2x13, a-b
EFS05-Steckerleiste        | Steckerleiste 113 - 05 TGL 29331/04, Leiterplattenanschluß, gerade, h=8,5mm, 1x5, versetzt
EFS13-Steckerleiste        | Steckerleiste 113 - 13 TGL 29331/04, Leiterplattenanschluß, gerade, h=8,5mm, 1x13, versetzt
EFS58-Steckerleiste        | Steckerleiste 122 - 58 TGL 29331/03, Lötanschluß, gerade, h=8,5mm, 2x29, a-b
EFS90-Steckerleiste        | Steckerleiste 122 - 90 TGL 29331/03, Lötanschluß, gerade, h=8,5mm, 2x45, a-b
EFS29-Steckerleiste        | Steckerleiste 123 - 29 TGL 29331/03, Lötanschluß, gerade, h=8,5mm, Raster 2,5mm versetzt
EFS45-Steckerleiste        | Steckerleiste 123 - 45 TGL 29331/03, Lötanschluß, gerade, h=8,5mm, Raster 2,5mm versetzt
EFS30-Steckerleiste        | Steckerleiste 127 - 30 TGL 29331/03, Lötanschluß, gerade, h=8,5mm, 2x15, a-b
EFS46-Steckerleiste        | Steckerleiste 127 - 46 TGL 29331/03, Lötanschluß, gerade, h=8,5mm, 2x23, a-b
EFS10-Buchsenleiste        | Buchsenleiste 202 - 10 TGL 29331/04, Leiterplattenanschluß, gewinkelt, h=8,7mm, 2x5, a-b
EFS26-Buchsenleiste        | Buchsenleiste 202 - 26 TGL 29331/04, Leiterplattenanschluß, gewinkelt, h=8,7mm, 2x13, a-b
EFS58-Buchsenleiste        | Buchsenleiste 202 - 58 TGL 29331/03, Leiterplattenanschluß, gewinkelt, h=8,7mm, 2x29, a-b
EFS90-Buchsenleiste        | Buchsenleiste 202 - 90 TGL 29331/03, Leiterplattenanschluß, gewinkelt, h=8,7mm, 2x45, a-b
EFS05-Buchsenleiste        | Buchsenleiste 203 - 05 TGL 29331/04, Leiterplattenanschluß, gewinkelt, h=8,7mm, 1x5, versetzt
EFS13-Buchsenleiste        | Buchsenleiste 203 - 13 TGL 29331/04, Leiterplattenanschluß, gewinkelt, h=8,7mm, 1x13, versetzt
EFS29-Buchsenleiste        | Buchsenleiste 203 - 29 TGL 29331/03, Leiterplattenanschluß, gewinkelt, h=8,7mm, 1x29, a-b
EFS45-Buchsenleiste        | Buchsenleiste 203 - 45 TGL 29331/03, Leiterplattenanschluß, gewinkelt, h=8,7mm, 1x45, a-b
EFS30-Buchsenleiste        | Buchsenleiste 207 - 30 TGL 29331/03, Leiterplattenanschluß, gewinkelt, h=8,7mm, 2x15, a-b
EFS46-Buchsenleiste        | Buchsenleiste 207 - 46 TGL 29331/03, Leiterplattenanschluß, gewinkelt, h=8,7mm, 2x23, a-b
EFS10-Buchsenleiste        | Buchsenleiste 212 - 10 TGL 29331/04, Leiterplattenanschluß, gerade, h=8,5mm, 2x5, a-b
EFS26-Buchsenleiste        | Buchsenleiste 212 - 26 TGL 29331/04, Leiterplattenanschluß, gerade, h=8,5mm, 2x13, a-b
EFS58-Buchsenleiste        | Buchsenleiste 212 - 58 TGL 29331/03, Leiterplattenanschluß, gerade, 2,5mm, 2x29
EFS90-Buchsenleiste        | Buchsenleiste 212 - 90 TGL 29331/03, Leiterplattenanschluß, gerade, 2,5mm, 2x45
EFS05-Buchsenleiste        | Buchsenleiste 213 - 05 TGL 29331/04, Leiterplattenanschluß, gerade, h=8,5mm, 1x5, versetzt
EFS13-Buchsenleiste        | Buchsenleiste 213 - 13 TGL 29331/04, Leiterplattenanschluß, gerade, h=8,5mm, 1x13, versetzt
EFS29-Buchsenleiste        | Buchsenleiste 213 - 29 TGL 29331/03, Leiterplattenanschluß, gerade, 2,5mm, 1x29
EFS45-Buchsenleiste        | Buchsenleiste 213 - 45 TGL 29331/03, Leiterplattenanschluß, gerade, 2,5mm, 1x45
EFS30-Buchsenleiste        | Buchsenleiste 217 - 30 TGL 29331/03, Leiterplattenanschluß, gerade, 5mm, 2x15
EFS46-Buchsenleiste        | Buchsenleiste 217 - 46 TGL 29331/03, Leiterplattenanschluß, gerade, 5mm, 2x23
EFS58-Buchsenleiste        | Buchsenleiste 222 - 58 TGL 29331/03, Lötanschluß, gerade, 2,5mm, 2x29
EFS90-Buchsenleiste        | Buchsenleiste 222 - 90 TGL 29331/03, Lötanschluß, gerade, 2,5mm, 2x45
EFS29-Buchsenleiste        | Buchsenleiste 223 - 29 TGL 29331/03, Lötanschluß, gerade, 2,5mm, 1x29
EFS45-Buchsenleiste        | Buchsenleiste 223 - 45 TGL 29331/03, Lötanschluß, gerade, 2,5mm, 1x45
EFS30-Buchsenleiste        | Buchsenleiste 227 - 30 TGL 29331/03, Lötanschluß, gerade, 5mm, 2x15
EFS46-Buchsenleiste        | Buchsenleiste 227 - 46 TGL 29331/03, Lötanschluß, gerade, 5mm, 2x23
EFS15-Steckerleiste        | Steckerleiste 302 - 15 TGL 29331/04, Leiterplattenanschluß, gewinkelt, h=13,7mm, 3x5, a-b-c
EFS39-Steckerleiste        | Steckerleiste 302 - 39 TGL 29331/04, Leiterplattenanschluß, gewinkelt, h=13,7mm, 3x13, a-b-c
EFS87-Steckerleiste        | Steckerleiste 302 - 87 TGL 29331/03, Leiterplattenanschluß, gewinkelt, h=13,7mm, 3x29, a-b-c
EFS08-Steckerleiste        | Steckerleiste 303 - 08 TGL 29331/04, Leiterplattenanschluß, gewinkelt, h=13,7mm, Raster 2,5mm versetzt
EFS20-Steckerleiste        | Steckerleiste 303 - 20 TGL 29331/04, Leiterplattenanschluß, gewinkelt, h=13,7mm, Raster 2,5mm versetzt
EFS44-Steckerleiste        | Steckerleiste 303 - 44 TGL 29331/03, Leiterplattenanschluß, gewinkelt, h=13,7mm, Raster 2,5mm versetzt
EFS10-Steckerleiste_a-c    | Steckerleiste 304 - 10 TGL 29331/04, Leiterplattenanschluß, gewinkelt, h=13,7mm, 2x5, a-c
EFS26-Steckerleiste_a-c    | Steckerleiste 304 - 26 TGL 29331/04, Leiterplattenanschluß, gewinkelt, h=13,7mm, 2x13, a-c
EFS58-Steckerleiste_a-c    | Steckerleiste 304 - 58 TGL 29331/03, Leiterplattenanschluß, gewinkelt, h=13,7mm, 2x29, a-c
EFS06-Steckerleiste_a-c    | Steckerleiste 305 - 06 TGL 29331/04, Leiterplattenanschluß, gewinkelt, h=13,7mm, 2x3, a-c
EFS14-Steckerleiste_a-c    | Steckerleiste 305 - 14 TGL 29331/04, Leiterplattenanschluß, gewinkelt, h=13,7mm, 2x7, a-c
EFS30-Steckerleiste_a-c    | Steckerleiste 305 - 30 TGL 29331/03, Leiterplattenanschluß, gewinkelt, h=13,7mm, 2x15, a-c
EFS15-Steckerleiste        | Steckerleiste 312 - 15 TGL 29331/04, Leiterplattenanschluß, gerade, h=13,5mm, 3x5, a-b-c
EFS39-Steckerleiste        | Steckerleiste 312 - 39 TGL 29331/04, Leiterplattenanschluß, gerade, h=13,5mm, 3x13, a-b-c
EFS08-Steckerleiste        | Steckerleiste 313 - 08 TGL 29331/04, Leiterplattenanschluß, gerade, h=13,5mm, Raster 2,5mm versetzt
EFS20-Steckerleiste        | Steckerleiste 313 - 20 TGL 29331/04, Leiterplattenanschluß, gerade, h=13,5mm, Raster 2,5mm versetzt
EFS10-Steckerleiste_a-c    | Steckerleiste 314 - 10 TGL 29331/04, Leiterplattenanschluß, gerade, h=13,5mm, 2x5, a-c
EFS26-Steckerleiste_a-c    | Steckerleiste 314 - 26 TGL 29331/04, Leiterplattenanschluß, gerade, h=13,5mm, 2x13, a-c
EFS06-Steckerleiste_a-c    | Steckerleiste 315 - 06 TGL 29331/04, Leiterplattenanschluß, gerade, h=13,5mm, 2x3, a-c
EFS14-Steckerleiste_a-c    | Steckerleiste 315 - 14 TGL 29331/04, Leiterplattenanschluß, gerade, h=13,5mm, 2x7, a-c
EFS87-Steckerleiste        | Steckerleiste 322 - 87 TGL 29331/03, Lötanschluß, gerade, h=13,7mm, 3x29, a-b-c
EFS44-Steckerleiste        | Steckerleiste 323 - 44 TGL 29331/03, Lötanschluß, gerade, h=13,7mm, Rster 2,5mm versetzt
EFS58-Steckerleiste_a-c    | Steckerleiste 324 - 58 TGL 29331/03, Lötanschluß, gerade, h=13,7mm, 2x29, a-c
EFS30-Steckerleiste_a-c    | Steckerleiste 325 - 30 TGL 29331/03, Lötanschluß, gerade, h=13,7mm, 2x15, a-c
EFS15-Buchsenleiste        | Buchsenleiste 402 - 15 TGL 29331/04, Leiterplattenanschluß, gewinkelt, h=13,7mm, 3x5, a-b-c
EFS39-Buchsenleiste        | Buchsenleiste 402 - 39 TGL 29332/04, Leiterplattenanschluß, gewinkelt, h=13,7mm, 3x13, a-b-c
EFS87-Buchsenleiste        | Buchsenleiste 402 - 87 TGL 29331/03, Leiterplattenanschluß, gewinkelt, h=13,7mm, 3x29, a-b-c
EFS08-Buchsenleiste        | Buchsenleiste 403 - 08 TGL 29331/04, Leiterplattenanschluß, gewinkelt, h=13,7mm, Raster 2,5mm versetzt
EFS20-Buchsenleiste        | Buchsenleiste 403 - 20 TGL 29331/04, Leiterplattenanschluß, gewinkelt, h=13,7mm, Raster 2,5mm versetzt
EFS44-Buchsenleiste        | Buchsenleiste 403 - 44 TGL 29331/03, Leiterplattenanschluß, gewinkelt, h=13,7mm, Raster 2,5mm versetzt
EFS10-Buchsenleiste_a-c    | Buchsenleiste 404 - 10 TGL 29331/04, Leiterplattenanschluß, gewinkelt, h=13,7mm, 2x5, a-c
EFS26-Buchsenleiste_a-c    | Buchsenleiste 404 - 26 TGL 29331/04, Leiterplattenanschluß, gewinkelt, h=13,7mm, 2x13, a-c
EFS58-Buchsenleiste_a-c    | Buchsenleiste 404 - 58 TGL 29331/03, Leiterplattenanschluß, gewinkelt, h=13,7mm, 2x29, a-c
EFS06-Buchsenleiste_a-c    | Buchsenleiste 405 - 06 TGL 29331/04, Leiterplattenanschluß, gewinkelt, h=13,7mm, 2x3, a-c
EFS14-Buchsenleiste_a-c    | Buchsenleiste 405 - 14 TGL 29331/04, Leiterplattenanschluß, gewinkelt, h=13,7mm, 2x7, a-c
EFS30-Buchsenleiste_a-c    | Buchsenleiste 405 - 30 TGL 29331/03, Leiterplattenanschluß, gewinkelt, h=13,7mm, 2x15, a-c
EFS15-Buchsenleiste        | Buchsenleiste 412 - 15 TGL 29331/04, Leiterplattenanschluß, gerade, h=13,7mm, 3x5, a-b-c
EFS39-Buchsenleiste        | Buchsenleiste 412 - 39 TGL 29331/04, Leiterplattenanschluß, gerade, h=13,7mm, 3x13, a-b-c
EFS87-Buchsenleiste        | Buchsenleiste 412 - 87 TGL 29331/03, Leiterplattenanschluß, gerade, h=13,7mm, 3x29, a-b-c
EFS08-Buchsenleiste        | Buchsenleiste 413 - 08 TGL 29331/04, Leiterplattenanschluß, gerade, h=13,7mm , Raster 2,5mm versetzt
EFS20-Buchsenleiste        | Buchsenleiste 413 - 20 TGL 29331/04, Leiterplattenanschluß, gerade, h=13,7mm , Raster 2,5mm versetzt
EFS44-Buchsenleiste        | Buchsenleiste 413 - 44 TGL 29331/03, Leiterplattenanschluß, gerade, h=13,7mm , Raster 2,5mm versetzt
EFS10-Buchsenleiste_a-c    | Buchsenleiste 414 - 10 TGL 29331/04, Leiterplattenanschluß, gerade, h=13,7mm, 2x5, a-c
EFS26-Buchsenleiste_a-c    | Buchsenleiste 414 - 26 TGL 29331/04, Leiterplattenanschluß, gerade, h=13,7mm, 2x13, a-c
EFS58-Buchsenleiste_a-c    | Buchsenleiste 414 - 58 TGL 29331/03, Leiterplattenanschluß, gerade, h=13,7mm, 2x29, a-c
EFS06-Buchsenleiste_a-c    | Buchsenleiste 415 - 06 TGL 29331/04, Leiterplattenanschluß, gerade, h=13,7mm , 2x3, a-c
EFS14-Buchsenleiste_a-c    | Buchsenleiste 415 - 14 TGL 29331/04, Leiterplattenanschluß, gerade, h=13,7mm , 2x7, a-c
EFS30-Buchsenleiste_a-c    | Buchsenleiste 415 - 30 TGL 29331/03, Leiterplattenanschluß, gerade, h=13,7mm, 2x15, a-c
EFS87-Buchsenleiste        | Buchsenleiste 422 - 87 TGL 29331/03, Lötanschluß, gerade, h=13,7mm , 3x29, a-b-c
EFS44-Buchsenleiste        | Buchsenleiste 423 - 44 TGL 29331/03, Lötanschluß, gerade, h=13,7mm , Raster 2,5mm versetzt
EFS58-Buchsenleiste_a-c    | Buchsenleiste 424 - 58 TGL 29331/03, Lötanschluß, gerade, h=13,7mm, 2x29, a-c
EFS30-Buchsenleiste_a-c    | Buchsenleiste 425 - 30 TGL 29331/03, Lötanschluß, gerade, h=13,7mm, 2x15, a-c

## sonstiges

Bezeichnung           | Beschreibung
--------------------- | ------------
R_Potentiometer       | Potentiometer mit 3 Pins
R_Potentiometer_Small | Potentiometer mit 3 Pins, kleines Symbol
R_Potentiometer_Trim  | Trimmer mit 3 Pins
