boert/RFT-kicad-library/(commit log)

2019-12-07 first devices
2019-12-07 complete opto coupler, add CCD
2020-08-08 add LEDs
2022-02-01 E-Line Footprints ergänzt
2022-03-16 update footprints
2022-11-11 add: kicad 6 files
2022-11-11 remove: kicad 5 files
2022-11-11 remove: Kicad 5 project file
2022-12-06 add: RGK20 footprints
2022-12-06 add: RGK13 footprints
2022-12-06 add: NSF30 footprints
2022-12-06 add: GRB111 footprint
2022-12-06 add: GRB20 footprint
2022-12-06 add: GRB11, GRB12, GBR13 footprint
2022-12-06 add: GRB10 footprint
2022-12-06 add: GRB7 footprint
2022-12-07 add: some separated relay versions
2022-12-28 fix: footprint assignments
2023-01-01 add: SA403, SA412, SA418 and footprints
2023-01-02 add: SAY30/32/40/42, Footprints modifiziert
2023-01-03 fix: footprint
2023-01-03 fix: GBR7 footprint
2023-01-03 add: RGK30/1 und RGK30/2
2023-01-04 fix: flip footprint
2023-01-05 rename: Footprint
2023-01-06 add: Transistor-Footprints
2023-01-08 add: Pin-Zählhilfe
2023-01-16 add: SP201, SP211 (ohne Footprint)
2023-01-18 add: Dioden-Footprints
2023-01-18 add: Widerstands-Footprints
2023-01-20 add: Ge-Dioden
2023-01-20 fix: Diodensymbol gedreht
2023-05-04 add: Hall-Elemente
2024-01-22 u555: remove duplicate pin 21 (Upp)
2024-01-24 u202: fix chip-select pin
2024-01-25 add: К561ЛЕ6
2024-02-11 add: К561ЛА7 К561ЛА8 К561ТР2
2024-02-11 add: К561ИМ1
